wagiminator/ATtiny13-TinyBling/hardware/TinyBling_BOM.tsv

ID | Name | Designator | Footprint | Quantity | Manufacturer Part | Manufacturer | Supplier | Supplier Part | Price
1 | LIR2032 | BAT | CR2032-SMD | 1
2 | 100n | C1 | 0603 | 1 | CC0603KRX7R9BB104 | YAGEO | LCSC | C14663 | 0.002
3 | 10u | C2 | 0603 | 1 | CL10A106MA8NRNC | SAMSUNG | LCSC | C96446
4 | WS2812-2020 | LED1,LED2,LED3,LED4,LED5,LED6,LED7,LED8,LED9,LED10,LED11,LED12,LED13,LED14,LED15,LED16 | WS2812-2020 | 16 | WS2812C-2020 | worldsemi | LCSC | C965556 | 0.124
5 | 10k | R1 | 0603 | 1 | 0603WAF1002T5E | UniOhm | LCSC | C25804 | 0.001
6 | 330R | R3 | 0603 | 1 | 0603WAF3300T5E | UniOhm | LCSC | C23138 | 0.001
7 | POWER | SW1 | SW-SMD_SS-1290L-GLL-1.5MM | 1 | SS-1290L-GL L=1.5mm | RI SHENG | LCSC | C695418 | 0.102
8 | SET | SW2 | KEY-3.0*6.0 | 1 | 3x6x2.5Red head high temperature | ReliaPro | LCSC | C46491 | 0.023
9 | ATtiny13A | U1 | SOP-8_150MIL | 1 | ATTINY13A-SSU | MICROCHIP | LCSC | C14075 | 1.648
