wagiminator/ATtiny13-TinyBling/hardware/TinyBling_schematic.pdf

## Microcontroller

3.7V Battery | Power Switch | Tactile Switch

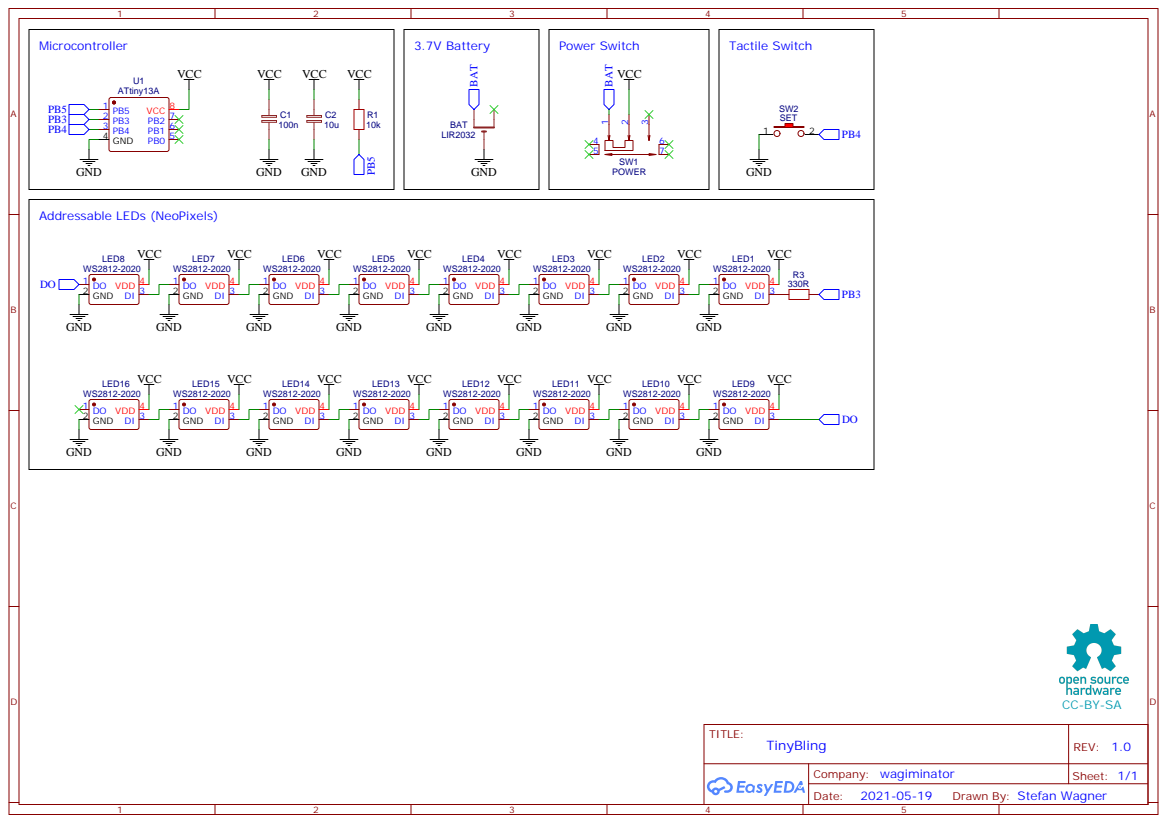
[picture p5: page 1]

Drawn By: Stefan Wagner
